tommysl8/ece145-function-generator/ltspice/blockA.asc

C1: polcap; 47µ
C2: cap; 100n
C3: polcap; 10µ
C4: cap; 100n
R1: res; 10k
R2: res; 10k
U1A: UniversalOpAmp2; Avol=200k GBW=3Meg Slew=13Meg; ilimit=25m rail=1.5 Vos=0 phimargin=45 en=0 enk=0 in=0 ink=0 Rin=1T
V1: voltage; PWL(0 0 20u 12)
Named nets: 0, vcc, vref
Block A: 12 V power input and buffered 6 V mid-rail reference (Vref).
.tran 0 0.5 0 uic
