tommysl8/ece145-function-generator/ltspice/blockB_v4.asc

CT: cap; 10n
IKICK: current; PULSE(0 100u 10u 1n 1n 20u 1)
RA: res; 5.1k
RBL: res; 10k
RBR: res; 10k
RIA: res; 56k
RIC: res; {22k+Rpot}
U1A: LM13700_v2; LM13700_SIM
U1B: LM13700_v2; LM13700_SIM
V1: voltage; PWL(0 0 20u 12)
VREF: voltage; 6
Named nets: vcc, 0, vref, nra, tri, sq
Block B: LM13700 oscillator generating the triangle and square waves (frequency set by RIC).
.lib LM13700_sim.lib
.param Rpot=1Meg
.tran 0 30m 0 1u uic
