tommysl8/ece145-function-generator/ltspice/blockC.asc

C1: cap; 100p
Q1: npn; 2N3904
Q2: npn; 2N3904
R1: res; 2.2k
R2: res; 390
R3: res; 4.7k
R4: res; 4.7k
R5: res; 390
R6a: res; 250
R6b: res; 250
R7: res; 10k
R8: res; 220
R9: res; 4.7k
R10: res; 4.7k
U1B: UniversalOpAmp2; Avol=200k GBW=3Meg Slew=13Meg; ilimit=25m rail=1.5 Vos=0 phimargin=45 en=0 enk=0 in=0 ink=0 Rin=1T
V1: voltage; 12
VREF: voltage; 6
VTRI: voltage; PULSE(5 7 0 0.5m 0.5m 1n 1m)
Named nets: vcc, 0, vref, tri, c1, sine
Block C: differential-pair shaper converting the 2 Vpp triangle into a sine wave (R6 = 500 ohm trim, shown as R6a + R6b).
.tran 0 10m 0 1u
.four 1k V(sine)
