tommysl8/ece145-function-generator/ltspice/blockD.asc

Cin: cap; 10u
RfN: res; 1k
RfS: res; 1k
RfT: res; 1k
RinN: res; 10k
RinS: res; 10k
RinT: res; 10k
RpN: res; {Rp}
RpS: res; {Rp}
RpT: res; {Rp}
U1: UniversalOpAmp2; Avol=200k GBW=3Meg Slew=13Meg; ilimit=25m rail=1.5 Vos=0 phimargin=45 en=0 enk=0 in=0 ink=0 Rin=1T
U2: UniversalOpAmp2; Avol=200k GBW=3Meg Slew=13Meg; ilimit=25m rail=1.5 Vos=0 phimargin=45 en=0 enk=0 in=0 ink=0 Rin=1T
U3: UniversalOpAmp2; Avol=200k GBW=3Meg Slew=13Meg; ilimit=25m rail=1.5 Vos=0 phimargin=45 en=0 enk=0 in=0 ink=0 Rin=1T
V1: voltage; 12
VREF: voltage; 6
VSIN: voltage; SINE(6 2.37 1k)
VSQ: voltage; PULSE(3.8 5.8 0 1u 1u 0.5m 1m)
VTRI: voltage; PULSE(5.04 6.96 0 0.5m 0.5m 1n 1m)
Named nets: vcc, 0, vref, tri, sq, sine, outT, outS, sqc, outN
Block D: output amplifiers that set the amplitude of each waveform (amplitude set by Rp).
.param Rp=18k
.step param Rp list 1 18k 47k 100k
.tran 0 5m 0 1u
.ic V(sqc)=5
.meas TRAN triPP PP V(outT) FROM 2m TO 5m
.meas TRAN sqPP PP V(outS) FROM 2m TO 5m
.meas TRAN sinePP PP V(outN) FROM 2m TO 5m
