tommysl8/ece145-function-generator/kicad/vref_generator.kicad_sch

## KiCad design kicad/vref_generator.kicad_sch (2026-11-10)


Parts:
C1: 47u
C2, C4: 100n
C3: 10u
R1, R2: 10k
U2: TL074

Connections:
12V: C1.1, C2.1, R1.1, U2.4 (V+)
GND: C1.2, C2.2, C3.2, C4.2, R2.2, U2.11 (V-)
unnamed: C3.1, C4.1, R1.2, R2.1, U2.3 (+)
V_{ref}: U2.1, U2.2 (-)
