tommysl8/ece145-function-generator/(commit log)

2026-11-10 Add KiCad project
    [ECE145_KiCAD.kicad_pcb, ECE145_KiCAD.kicad_sch]
2026-11-10 initial commit for vref generator
    [ECE145.kicad_pcb, ECE145.kicad_sch, ECE145_KiCAD.kicad_sch, vref_generator.kicad_sch]
